thomashkolbe/8080_Home_Computer/hardware/Video+Sound_Board_for_8080_Microprocessor_Kit.pdf

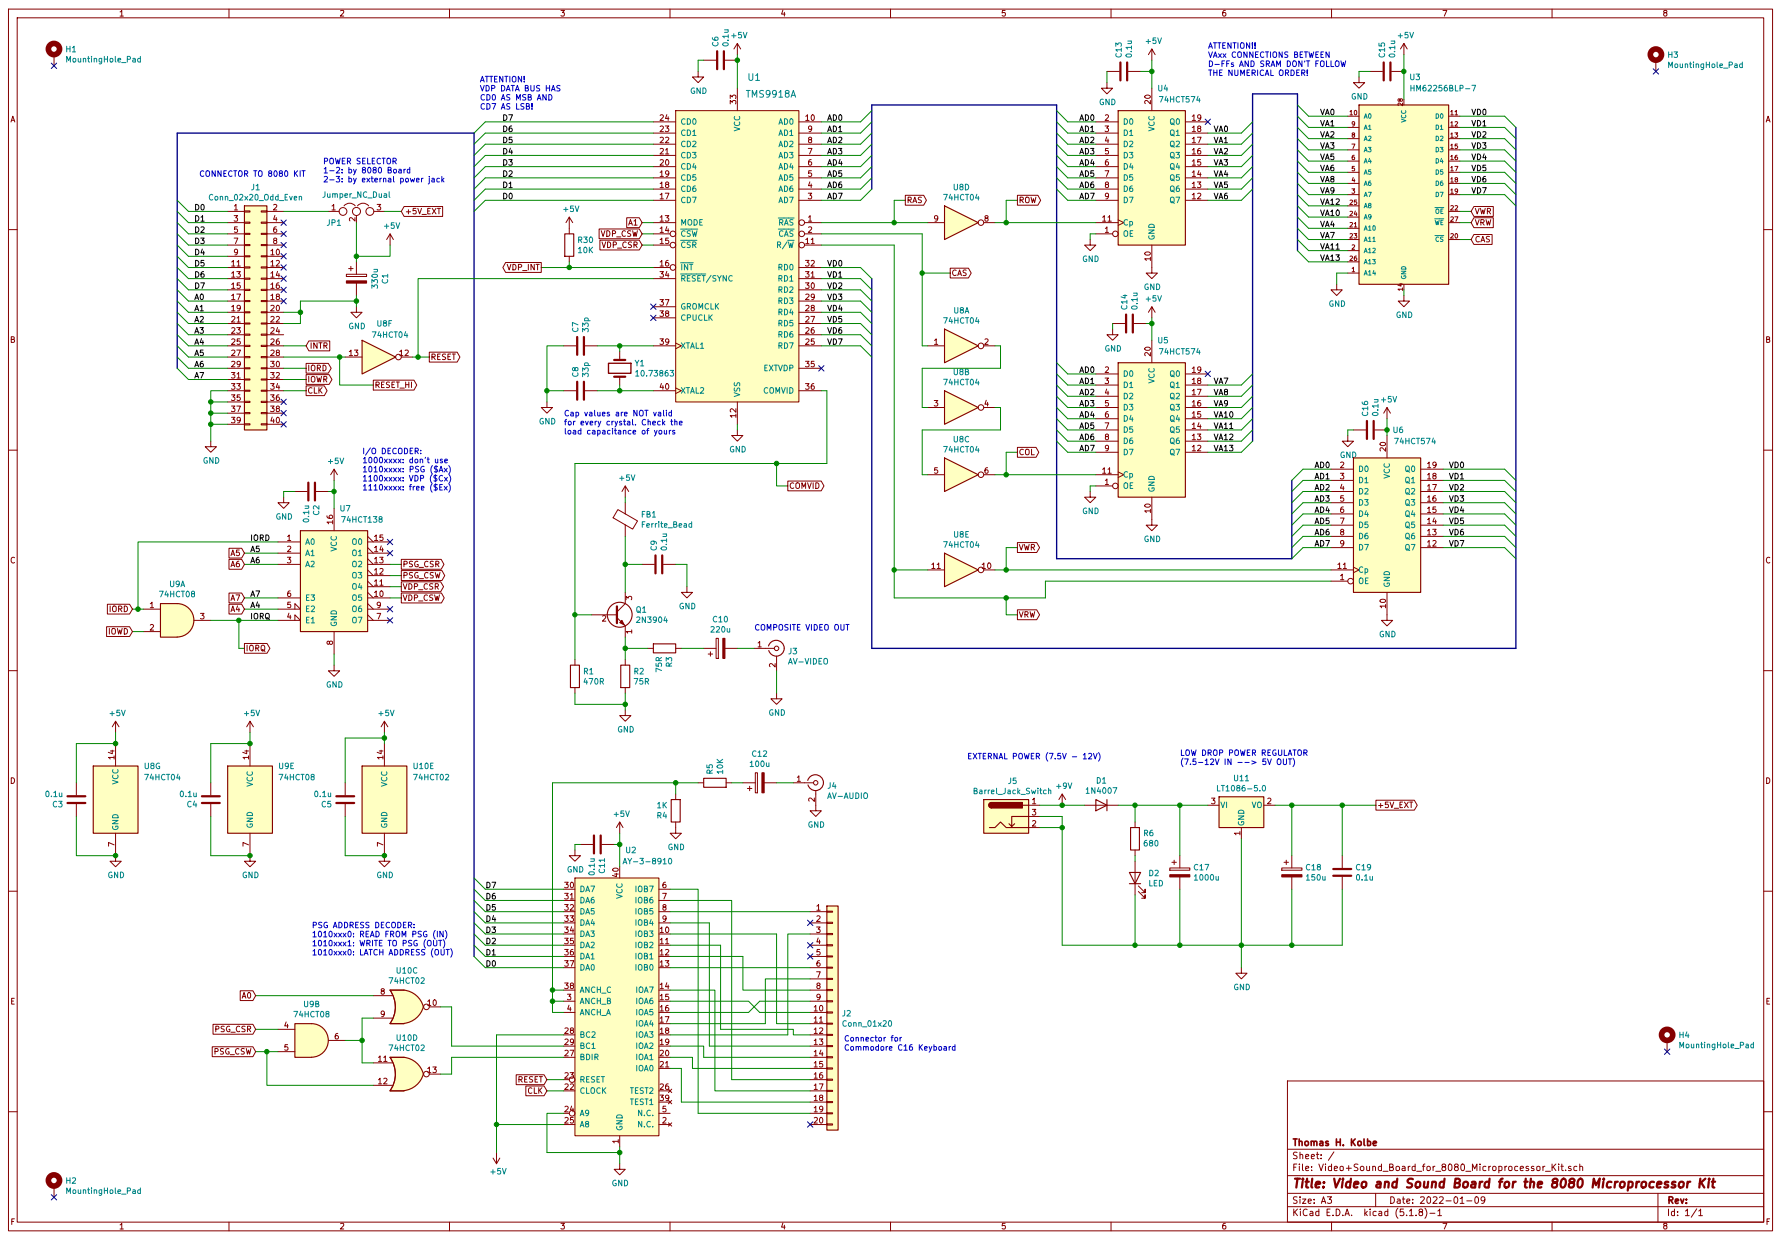
[picture p11: page 1]
