thomashkolbe/8080_Home_Computer/hardware/Video+Sound_Board_for_8080_Microprocessor_Kit.sch

## KiCad design hardware/Video+Sound_Board_for_8080_Microprocessor_Kit.sch (2022-01-09)

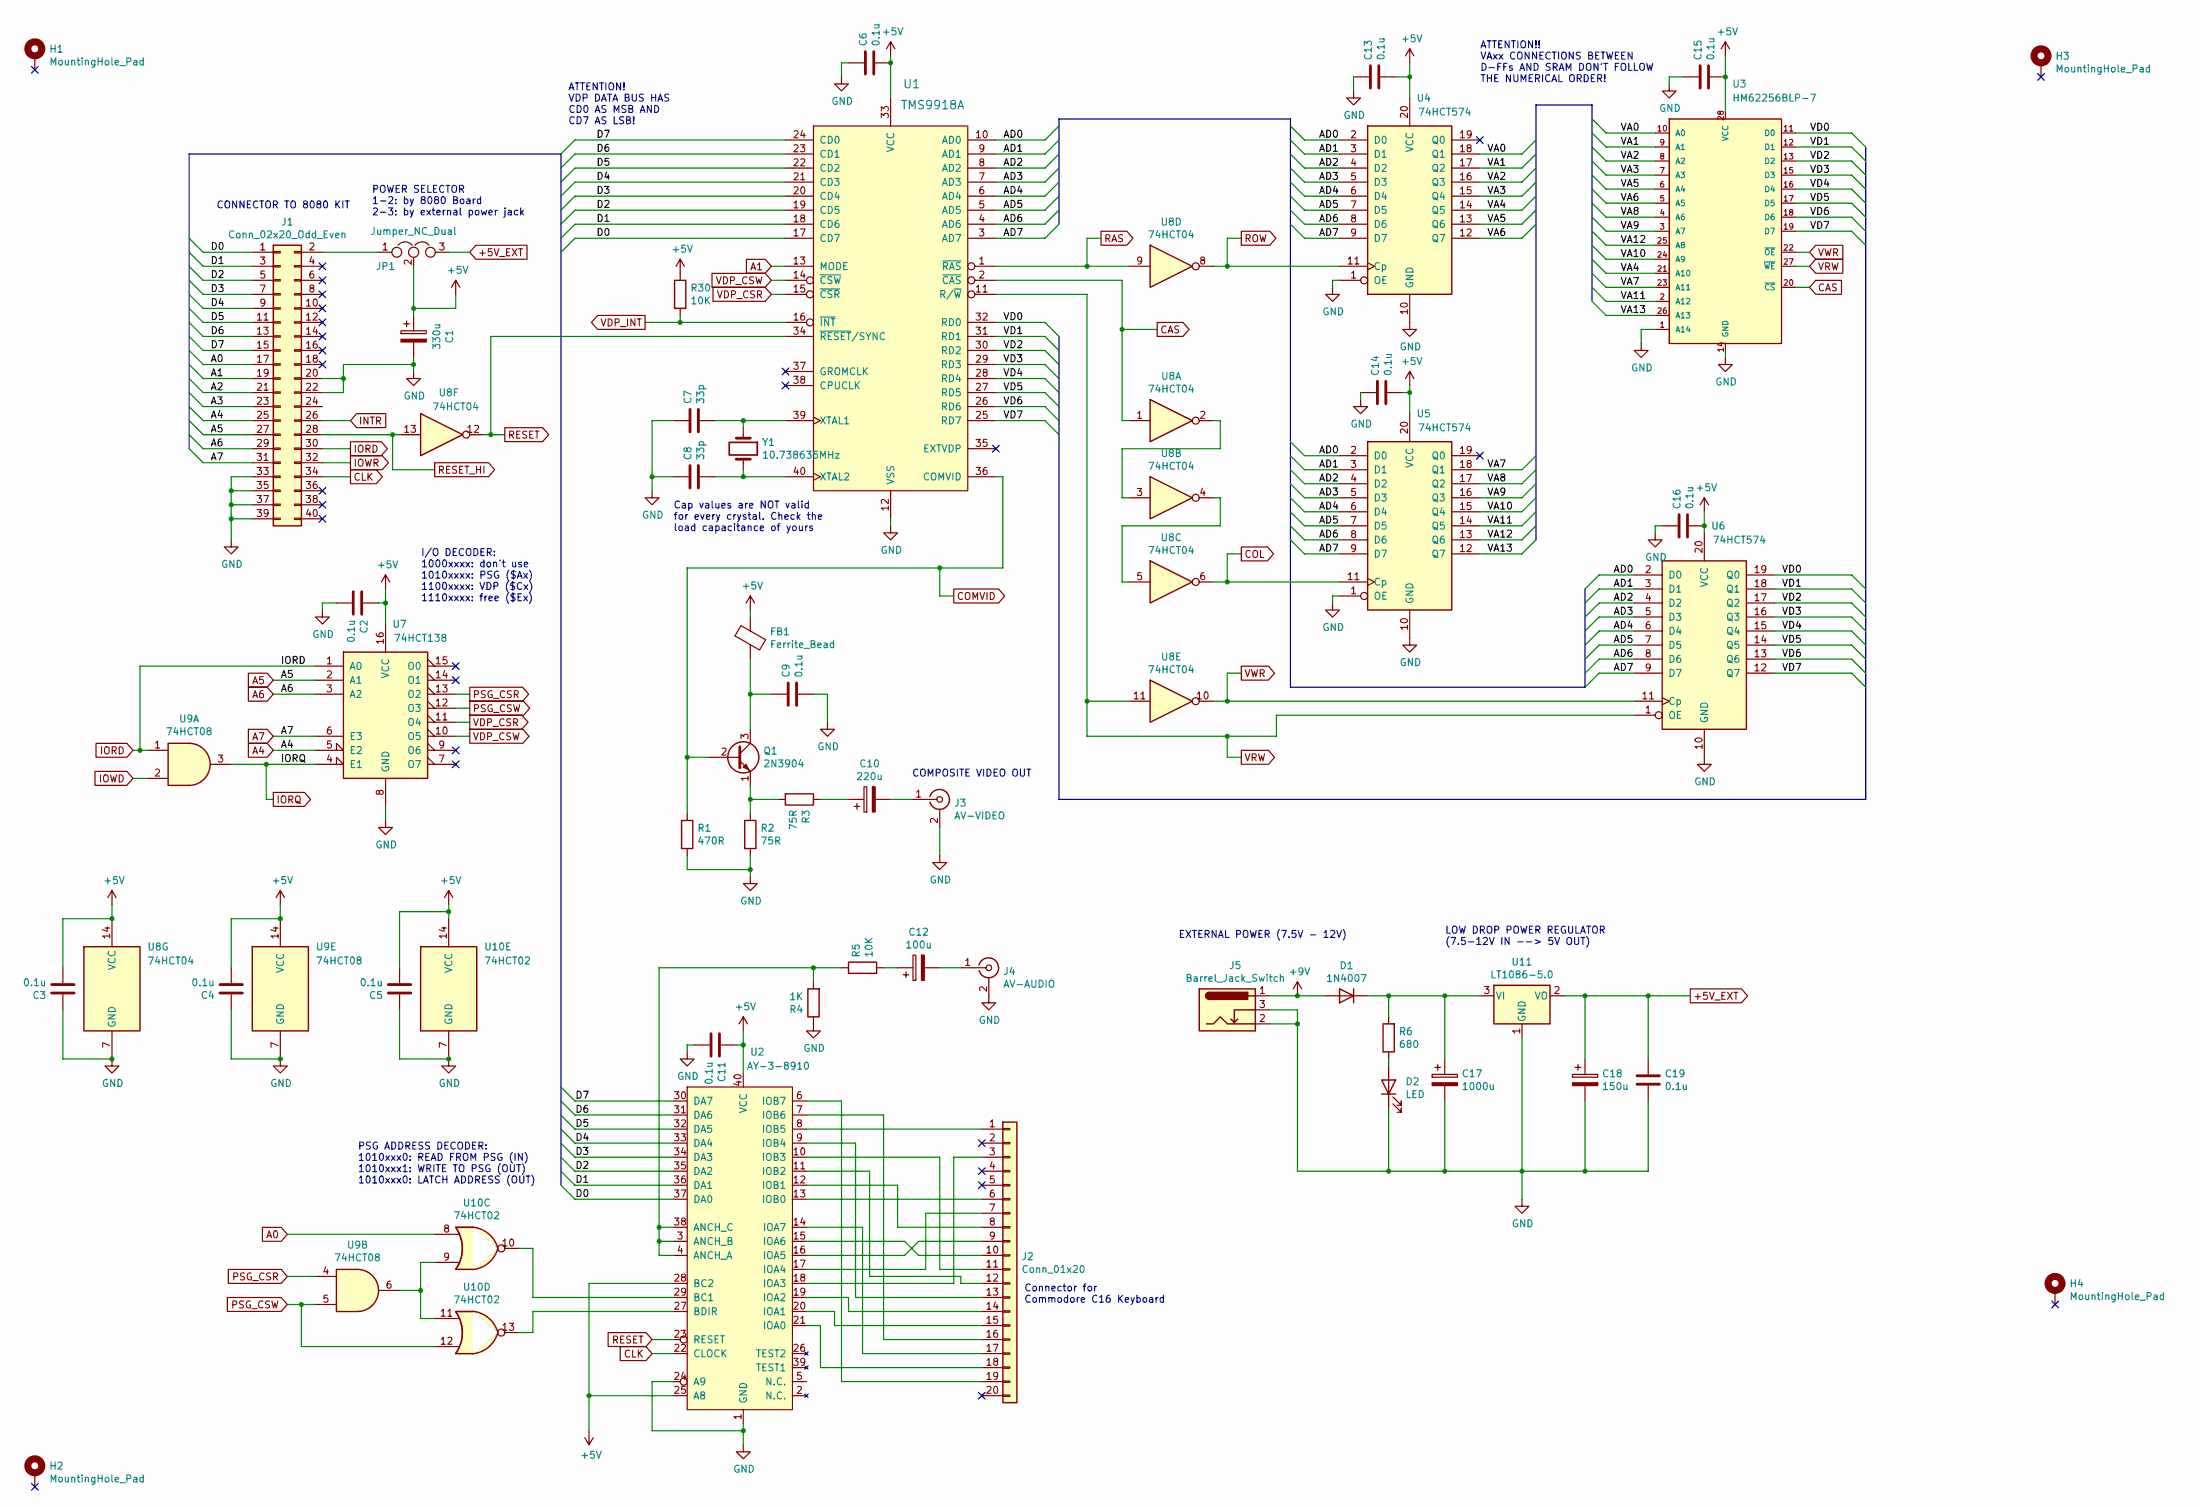
[picture p12: schematic Video+Sound_Board_for_8080_Microprocessor_Kit.sch]

Parts:
C1: 330u; CP_Radial_D10.0mm_P2.50mm
C2, C3, C4, C5, C6, C9, C11, C13, C14, C15, C16, C19: 0.1u; C_Disc_D5.0mm_W2.5mm_P2.50mm
C7, C8: 33p; C_Disc_D5.0mm_W2.5mm_P2.50mm
C10: 220u; CP_Radial_D10.0mm_P2.50mm
C12: 100u; CP_Radial_D4.0mm_P2.00mm
C17: 1000u; CP_Radial_D5.0mm_P2.00mm
C18: 150u; CP_Radial_D5.0mm_P2.00mm
D1: 1N4007; D_DO-41_SOD81_P10.16mm_Horizontal
D2: LED; LED_D5.0mm
FB1: Ferrite_Bead; LairdTech_28C0236-0JW-10
H1, H2, H3, H4: MountingHole_Pad; MountingHole_3.2mm_M3
J1: Conn_02x20_Odd_Even; PinHeader_2x20_P2.54mm_Vertical
J2: Conn_01x20; PinHeader_1x20_P2.54mm_Vertical
J3: AV-VIDEO; RCAsimple
J4: AV-AUDIO; RCAsimple
J5: Barrel_Jack_Switch; BarrelJack_Horizontal
JP1: Jumper_NC_Dual; PinHeader_1x03_P2.54mm_Vertical
Q1: 2N3904; TO-92_Inline
R1: 470R; R_Axial_DIN0207_L6.3mm_D2.5mm_P10.16mm_Horizontal
R2, R3: 75R; R_Axial_DIN0207_L6.3mm_D2.5mm_P10.16mm_Horizontal
R4: 1K; R_Axial_DIN0207_L6.3mm_D2.5mm_P10.16mm_Horizontal
R5, R30: 10K; R_Axial_DIN0207_L6.3mm_D2.5mm_P10.16mm_Horizontal
R6: 680; R_Axial_DIN0207_L6.3mm_D2.5mm_P10.16mm_Horizontal
U1: TMS9918A; DIP-40_W15.24mm_LongPads
U2: AY-3-8910; DIP-40_W15.24mm_LongPads
U3: HM62256BLP-7; DIP-28_W15.24mm_LongPads
U4, U5, U6: 74HCT574; DIP-20_W7.62mm_LongPads
U7: 74HCT138; DIP-16_W7.62mm_LongPads
U8: 74HCT04; DIP-14_W7.62mm_LongPads
U9: 74HCT08; DIP-14_W7.62mm_LongPads
U10: 74HCT02; DIP-14_W7.62mm_LongPads
U11: LT1086-5.0; TO-220-3_Vertical
Y1: 10.738635MHz; Crystal_HC18-U_Vertical

Connections:
+5V: C1.1, C2.1, C3.2, C4.2, C5.2, C6.2, C11.1, C13.2, C14.2, C15.2, C16.2, FB1.1, JP1.2, R30.1, U1.33 (VCC), U2.25 (A8), U2.28 (BC2), U2.40 (VCC), U3.28 (VCC), U4.20 (VCC), U5.20 (VCC), U6.20 (VCC), U7.16 (VCC), U8.14 (VCC), U9.14 (VCC), U10.14 (VCC)
+5V_EXT: C18.1, C19.1, JP1.3, U11.2 (VO)
+9V: D1.2 (A), J5.1
A0: J1.17, U10.8
A1: J1.19, U1.13 (MODE)
A2: J1.21
A3: J1.23
A4: J1.25, U7.5 (E2)
A5: J1.27, U7.2 (A1)
A6: J1.29, U7.3 (A2)
A7: J1.31, U7.6 (E3)
AD0: U1.10 (AD0), U4.2 (D0), U5.2 (D0), U6.2 (D0)
AD1: U1.9 (AD1), U4.3 (D1), U5.3 (D1), U6.3 (D1)
AD2: U1.8 (AD2), U4.4 (D2), U5.4 (D2), U6.4 (D2)
AD3: U1.7 (AD3), U4.5 (D3), U5.5 (D3), U6.5 (D3)
AD4: U1.6 (AD4), U4.6 (D4), U5.6 (D4), U6.6 (D4)
AD5: U1.5 (AD5), U4.7 (D5), U5.7 (D5), U6.7 (D5)
AD6: U1.4 (AD6), U4.8 (D6), U5.8 (D6), U6.8 (D6)
AD7: U1.3 (AD7), U4.9 (D7), U5.9 (D7), U6.9 (D7)
CAS: U1.2 (~CAS~), U3.20 (~CS), U8.1
CLK: J1.34, U2.22 (CLOCK)
COL: U5.11 (Cp), U8.6
COMVID: Q1.2 (B), R1.1, U1.36 (COMVID)
D0: J1.1, U1.17 (CD7), U2.37 (DA0)
D1: J1.3, U1.18 (CD6), U2.36 (DA1)
D2: J1.5, U1.19 (CD5), U2.35 (DA2)
D3: J1.7, U1.20 (CD4), U2.34 (DA3)
D4: J1.9, U1.21 (CD3), U2.33 (DA4)
D5: J1.11, U1.22 (CD2), U2.32 (DA5)
D6: J1.13, U1.23 (CD1), U2.31 (DA6)
D7: J1.15, U1.24 (CD0), U2.30 (DA7)
GND: C1.2, C2.2, C3.1, C4.1, C5.1, C6.1, C7.1, C8.1, C9.2, C11.2, C13.1, C14.1, C15.1, C16.1, C17.2, C18.2, C19.2, D2.1 (K), J1.20, J1.22, J1.33, J1.35, J1.37, J1.39, J3.2 (Ext), J4.2 (Ext), J5.2, J5.3, R1.2, R2.2, R4.1, U1.12 (VSS), U2.1 (GND), U2.24 (A9), U3.1 (A14), U3.14 (GND), U4.1 (OE), U4.10 (GND), U5.1 (OE), U5.10 (GND), U6.10 (GND), U7.8 (GND), U8.7 (GND), U9.7 (GND), U10.7 (GND), U11.1 (GND)
INTR: J1.26
IORD: J1.30, U7.1 (A0), U9.1
IORQ: U7.4 (E1), U9.3
IOWD: U9.2
IOWR: J1.32
unnamed: C7.2, U1.39 (XTAL1), Y1.1
unnamed: C8.2, U1.40 (XTAL2), Y1.2
unnamed: C9.1, FB1.2, Q1.3 (C)
unnamed: C10.1, R3.1
unnamed: C10.2, J3.1 (In)
unnamed: C12.1, R5.2
unnamed: C12.2, J4.1 (In)
unnamed: C17.1, D1.1 (K), R6.2, U11.3 (VI)
unnamed: D2.2 (A), R6.1
unnamed: J1.2, JP1.1
unnamed: J2.1, U2.8 (IOB5)
unnamed: J2.3, U2.18 (IOA3)
unnamed: J2.6, U2.13 (IOB0)
unnamed: J2.7, U2.17 (IOA4)
unnamed: J2.8, U2.12 (IOB1)
unnamed: J2.9, U2.16 (IOA5)
unnamed: J2.10, U2.15 (IOA6)
unnamed: J2.11, U2.10 (IOB3)
unnamed: J2.12, U2.11 (IOB2)
unnamed: J2.13, U2.9 (IOB4)
unnamed: J2.14, U2.19 (IOA2)
unnamed: J2.15, U2.20 (IOA1)
unnamed: J2.16, U2.7 (IOB6)
unnamed: J2.17, U2.14 (IOA7)
unnamed: J2.18, U2.21 (IOA0)
unnamed: J2.19, U2.6 (IOB7)
unnamed: Q1.1 (E), R2.1, R3.2
unnamed: R4.2, R5.1, U2.3 (ANCH_B), U2.4 (ANCH_A), U2.38 (ANCH_C)
unnamed: U8.2, U8.3
unnamed: U8.4, U8.5
unnamed: U2.29 (BC1), U10.10
unnamed: U9.6, U10.9, U10.11
unnamed: U2.27 (BDIR), U10.13
PSG_CSR: U7.13 (O2), U9.4
PSG_CSW: U7.12 (O3), U9.5, U10.12
RAS: U1.1 (~RAS~), U8.9
RESET: U1.34 (~RESET~/SYNC), U2.23 (RESET), U8.12
RESET_HI: J1.28, U8.13
ROW: U4.11 (Cp), U8.8
VA0: U3.10 (A0), U4.18 (Q1)
VA1: U3.9 (A1), U4.17 (Q2)
VA2: U3.8 (A2), U4.16 (Q3)
VA3: U3.7 (A3), U4.15 (Q4)
VA4: U3.21 (A10), U4.14 (Q5)
VA5: U3.6 (A4), U4.13 (Q6)
VA6: U3.5 (A5), U4.12 (Q7)
VA7: U3.23 (A11), U5.18 (Q1)
VA8: U3.4 (A6), U5.17 (Q2)
VA9: U3.3 (A7), U5.16 (Q3)
VA10: U3.24 (A9), U5.15 (Q4)
VA11: U3.2 (A12), U5.14 (Q5)
VA12: U3.25 (A8), U5.13 (Q6)
VA13: U3.26 (A13), U5.12 (Q7)
VD0: U1.32 (RD0), U3.11 (D0), U6.19 (Q0)
VD1: U1.31 (RD1), U3.12 (D1), U6.18 (Q1)
VD2: U1.30 (RD2), U3.13 (D2), U6.17 (Q2)
VD3: U1.29 (RD3), U3.15 (D3), U6.16 (Q3)
VD4: U1.28 (RD4), U3.16 (D4), U6.15 (Q4)
VD5: U1.27 (RD5), U3.17 (D5), U6.14 (Q5)
VD6: U1.26 (RD6), U3.18 (D6), U6.13 (Q6)
VD7: U1.25 (RD7), U3.19 (D7), U6.12 (Q7)
VDP_CSR: U1.15 (~CSR~), U7.11 (O4)
VDP_CSW: U1.14 (~CSW~), U7.10 (O5)
VDP_INT: R30.2, U1.16 (~INT~)
VRW: U1.11 (R/~W~), U3.27 (~WE), U6.1 (OE), U8.11
VWR: U3.22 (~OE), U6.11 (Cp), U8.10

Notes on the sheet:
LOW DROP POWER REGULATOR (7.5-12V IN --> 5V OUT)
ATTENTION! VDP DATA BUS HAS CD0 AS MSB AND CD7 AS LSB!
ATTENTION!! VAxx CONNECTIONS BETWEEN D-FFs AND SRAM DON’T FOLLOW THE NUMERICAL ORDER!
COMPOSITE VIDEO OUT
I/O DECODER: 1000xxxx: don't use 1010xxxx: PSG ($Ax) 1100xxxx: VDP ($Cx) 1110xxxx: free ($Ex)
Connector for Commodore C16 Keyboard
PSG ADDRESS DECODER: 1010xxx0: READ FROM PSG (IN) 1010xxx1: WRITE TO PSG (OUT) 1010xxx0: LATCH ADDRESS (OUT)
Cap values are NOT valid for every crystal. Check the load capacitance of yours
CONNECTOR TO 8080 KIT
POWER SELECTOR 1-2: by 8080 Board 2-3: by external power jack
EXTERNAL POWER (7.5V - 12V)
